emanuelturtula/DCE-GRUPO10/README.md

# DCE-GRUPO10

## Tareas pendientes 

* Eficiencia

* Distorsión
