emanuelturtula/DCE-GRUPO10/INTRODUCCION/ETAPAS/LOGICA DE CONTROL/logica.png

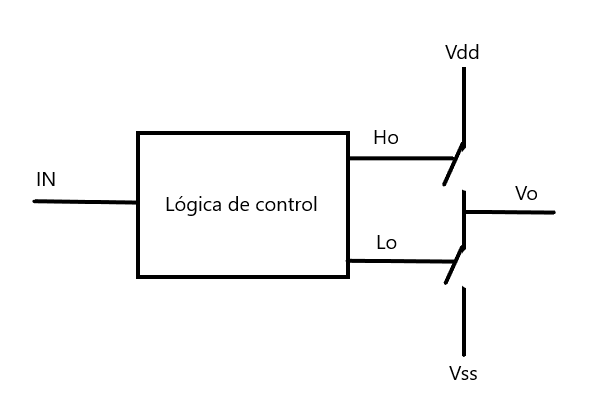
INTRODUCCION/ETAPAS/LOGICA DE CONTROL/logica.png
