emanuelturtula/DCE-GRUPO10/INTRODUCCION/ETAPAS/TRIANGULAR/generador_ideal.PNG

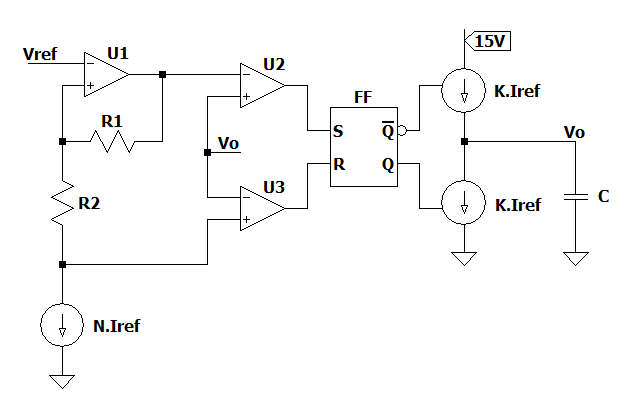
INTRODUCCION/ETAPAS/TRIANGULAR/generador_ideal.PNG
