emanuelturtula/DCE-GRUPO10/INTRODUCCION/TEORICA/diagrama.png

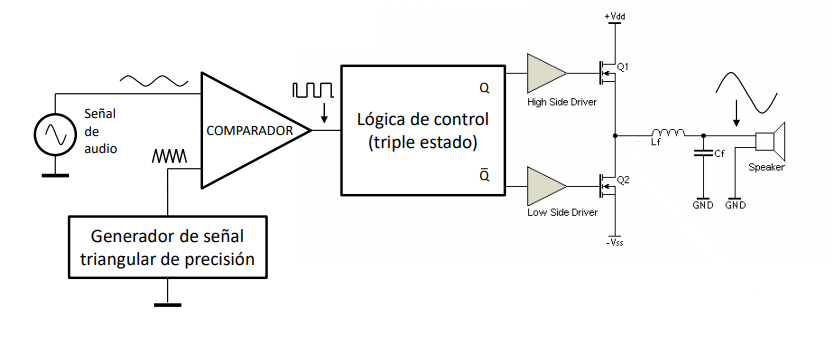
INTRODUCCION/TEORICA/diagrama.png
