emanuelturtula/DCE-GRUPO10/INTRODUCCION/TEORICA/PWM.png

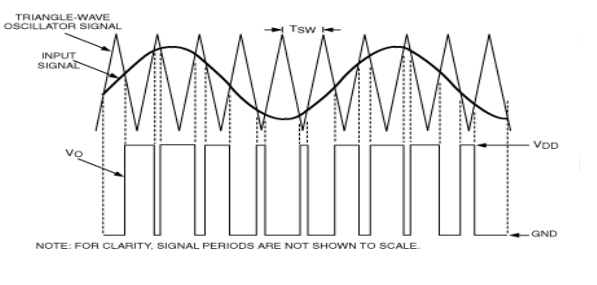
INTRODUCCION/TEORICA/PWM.png
