emanuelturtula/DCE-GRUPO10/REALIMENTADOR/PSpice/Realimentador-PSpiceFiles/SCHEMATIC1/tran/Dist_ol.png

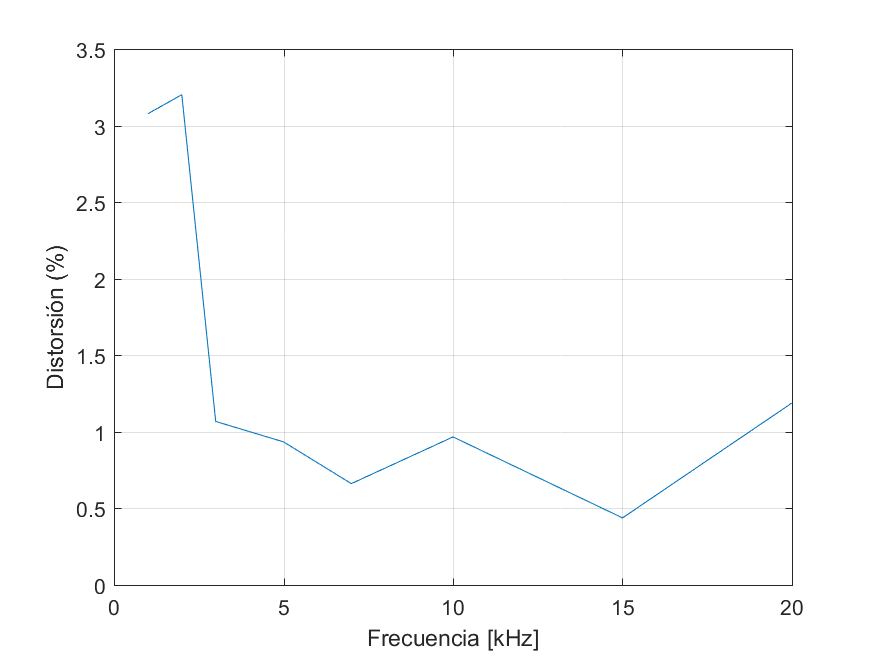
REALIMENTADOR/PSpice/Realimentador-PSpiceFiles/SCHEMATIC1/tran/Dist_ol.png
