emanuelturtula/DCE-GRUPO10/REALIMENTADOR/PSpice/Realimentador-PSpiceFiles/SCHEMATIC1/tran/Rta_cl.png

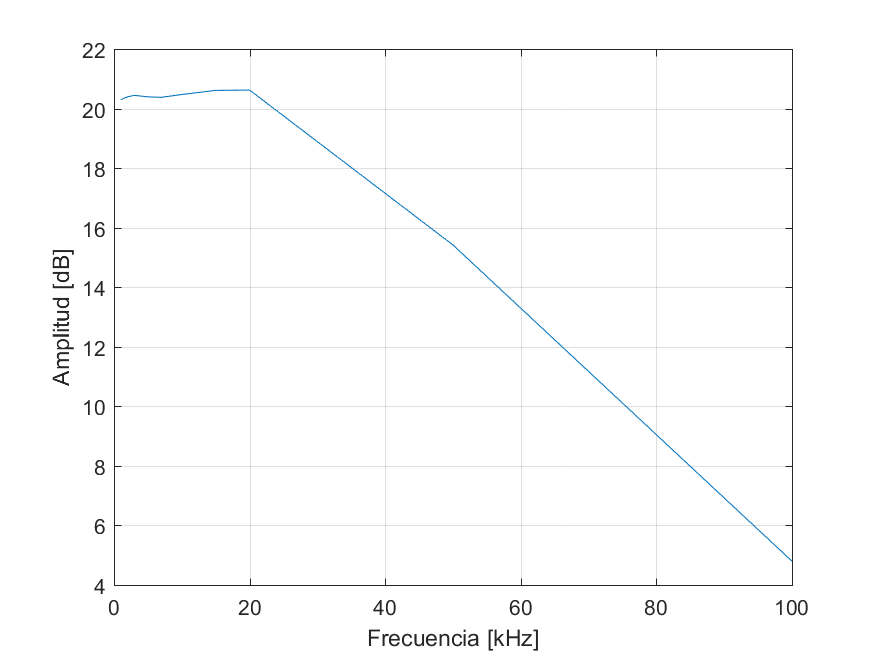
REALIMENTADOR/PSpice/Realimentador-PSpiceFiles/SCHEMATIC1/tran/Rta_cl.png
