emanuelturtula/DCE-GRUPO10/REALIMENTADOR/LTSpice/Conceptual.asc

A1: or; td=80n Vhigh=5 Vlow=0
C1: cap; {C}
C2: cap; 82p
C3: cap; 12p
Cf: cap; 330n
Lf: ind; 33µ
R1: res; 19k
R2: res; 1k
R3: res; 1k
R4: res; 1k
R5: res; 1k
R6: res; {R}
R7: res; {R}
R8: res; 10k
R9: res; 1k
RL: res; 8
S1: sw
S2: sw
SENOIDAL: voltage; SINE(0 1.1 {freq})
TRIANGULAR: voltage; PULSE(-1.5 1.5 0 2.5u 2.5u 0 5u)
U1: xcomp_x11; LM311
U2: opamp2; AD817
U3: opamp2; AD817
V1: voltage; 5
V5: voltage; 15
V6: voltage; 15
VCC: voltage; 30
VSS: voltage; 30
Named nets: 0, VEE, VCC, 5V, Vo, -15V, 15V, Vsin, Vtriang, Vf, error, Vcc
.tran 0 {STOP} {START} uic
.include UCC20520.301
Fuentes
Bibliotecas
Salida
Filtro
.include PHB27NQ10T.lib
.include BS170.301
.include LM311.301
Directivas SPICE
Entrada
Etapa de salida
.options numdgt = 15
Doble precision
.options plotwinsize = 0
Deshabilitar la compresion
.four {freq} {Narm} -1 V(vo)
.model SW SW(Ron=.01 Roff=10Meg Vt=1)
.include AD817.301
.param freq=20k
.param T=1/{freq}
.param Narm table(freq, 1k, 9, 10k, 6, 20k, 3)
.include TL082.301
.param R=100k
.param C=12p
.param fc=100k
.param STOP=(100u+11*{T})
.param START=(100u+{T})
