emanuelturtula/DCE-GRUPO10/REALIMENTADOR/LTSpice/Calculo.asc

B1: bv; V=20*delay(V(error), 200n)
B2: bv; V=delay(V(i), 200n)
C1: cap; {C}
C3: cap; {C}
C4: cap; 22p
C5: cap; 68p
Cf1: cap; 330n
Cf2: cap; 330n
Lf1: ind; 33µ
Lf2: ind; 33µ
R1: res; 1k
R3: res; 1k
R5: res; 8
R6: res; 19k
R7: res; 1k
R8: res; {R}
R9: res; {R}
R10: res; 9k
R11: res; 1k
R12: res; 19k
R13: res; 1k
R14: res; 8
U1: opamp2; AD817
U2: opamp2; AD817
V1: voltage; 5
V2: voltage; 5
V3: voltage; ""; AC 1
V4: voltage; ""; AC 1
V5: voltage; ""; AC 1
V6: voltage; ""; AC 1
V8: voltage; 15
V9: voltage; 15
V10: voltage; 30
V11: voltage; 30
Named nets: 0, -5V, 5V, 15V, -15V, vo, VEE, VCC, Vs, Vf, LC, COMP, f, i, error
.ac dec 10000 0.1 10Meg
.include AD817.301
.include LM311.301
.options plotwinsize = 0
.options numdgt = 15
.model SW SW(Ron=.01 Roff=10Meg Vt=1)
.include TL082.301
.param R=8.2k
.param C=220p
