emanuelturtula/DCE-GRUPO10/REALIMENTADOR/LTSpice/LazoAbierto-vs-LazoCerrado.asc

B1: bv; V=V(comp)*20
B2: bv; V=V(in)*20
C1: cap; 82p
C3: cap; 100p
Cf1: cap; 330n
Cf2: cap; 330n
Lf1: ind; 33µ
Lf2: ind; 33µ
R1: res; 100
R2: res; {R}
R3: res; {R}
R4: res; 100
R5: res; 8
R6: res; 19k
R7: res; 1k
R8: res; 8
R10: res; 10k
R11: res; 1k
U1: opamp2; AD817
V1: voltage; 15
V2: voltage; 15
V3: voltage; ""; AC 1
V6: voltage; ""; AC 1
Named nets: 0, -15V, 15V, error, F, comp, in, ol, cl
.ac dec 10000 0.1 100Meg
.include AD817.301
.param R=470k
