emanuelturtula/DCE-GRUPO10/DISTORSION/OTRAS/LAZO CERRADO/Dist_10k_cl.asc

A1: or; Vhigh=5  td=11n
A2: or; Vhigh=5  td=11n
B1: bv; V(if( V(error) > V(Vtriang), 5, 0))
BC1: npn
C1: cap; 1.8n
C2: cap; 1µ; IC=-7.5
C4: cap; 82p
C12: cap; 100p
Cf: cap; 330n
Lf: ind; 33µ
M3: nmos; BS170
M4: nmos; BS170
Q1: npn; BC847C
Q2: npn; BC847C
Q3: npn; BC847C
Q4: npn; BC847C
Q5: npn; BC847C
Q6: npn; BC847C
Q7: npn; BC847C
Q8: pnp; BC857C
Q9: pnp; BC857C
Q10: pnp; BC857C
Q11: pnp; BC857C
Q12: pnp; BC857C
R1: res; 560
R2: res; 560
R3: res; 1Meg
R4: res; 1Meg
R5: res; 12k
R6: res; 100
R7: res; 100
R8: res; 1k
R9: res; 1k
R10: res; 3.3k
R11: res; 100
R12: res; 100
R13: res; 100
R14: res; 100
R15: res; 1.8k
R17: res; 18k
R18: res; 1k
R19: res; 100
R20: res; 100
R21: res; {R}
R22: res; {R}
R23: res; 1k
R24: res; 10k
R26: res; 1k
RL: res; 8
S1: sw
S2: sw
SENOIDAL: voltage; SINE(0 {vin} {freq})
U1: xcomp_x11; LM311
U2: xcomp_x11; LM311
U3: opamp2; TL082
U5: opamp2; TL082
U8: opamp2; AD817
V1: voltage; 5
V2: voltage; 5
V5: voltage; 15
V6: voltage; 15
VCC: voltage; 30
VSS: voltage; 30
Named nets: 0, VCC, VEE, 5V, -5V, Vo, -15V, 15V, Vcap, Charge, Discharge, Vsin, Vtriang, error
.include UCC20520.301
Fuentes
Bibliotecas
Salida
Filtro
.include PHB27NQ10T.lib
.include BS170.301
.include LM311.301
Directivas SPICE
Generador de onda triangular
Entrada
Etapa de salida
.options numdgt = 15
Doble precision
.options plotwinsize = 0
Deshabilitar la compresion
.param freq=10k
.param time=10/{freq}+200u
.param R=470k
.tran 0 {time} 200u uic
.four {freq} {Narm} -1 V(vo)
.include AD817.301
.include TL082.301
.param Narm table(freq, 1k, 9, 10k, 6, 20k, 3)
Numero de armonicos segun frecuencia
Tiempo de simulacion para 10 períodos
NO TOCAR ESTAS DIRECTIVAS
Resistencias del amplificador de error. La ganancia es R/100
Frecuencia de entrada
.param vin=1.1
Tension de entrada pico a pico
.model SW SW(Ron=.01 Roff=10Meg Vt=1)
