emanuelturtula/DCE-GRUPO10/DISTORSION/INTERMODULACION/Intermod_1W&30W.asc

C3: cap; 2.2n
C4: cap; 33p
C5: cap; 1µ
C6: cap; 10µ
C7: cap; 10µ
C8: cap; 220n
C9: cap; 100n
C10: cap; 1n
C11: cap; 1n
C-BOOT: cap; 1µ
Cf: cap; 300n
D3: diode; MURS120
D4: diode; MURS320
D5: diode; MURS320
Lf: ind; 33µ
M1: nmos; PHB27NQ10T
M2: nmos; PHB27NQ10T
R16: res; 1k
R25: res; 2.2k
R26: res; 51
R27: res; 1.2
R28: res; 3.3
R29: res; 1.2
R30: res; 3.3
R-BOOT: res; 10
RL: res; 8
SENOIDAL_5kHZ: voltage; SINE(0 {vin}/4 5k)
SENOIDAL_100HZ: voltage; SINE(0 {vin} 100)
U4: UCC20520
U6: xcomp_x11; LM311
V1: voltage; 5
V2: voltage; 5
V3: voltage; 12
V4: voltage; PULSE(-1.5 1.5 0 2.5u 2.5u 0 5u)
V5: voltage; 15
V6: voltage; 15
VCC: voltage; 30
VSS: voltage; 30
Named nets: 0, VEE, VCC, 5V, -5V, HO, LO, Vo, DT, PWM-In, -15V, 15V, Vsin, Vtriang
.tran 0 11m 1m uic
.include UCC20520.301
Fuentes
Bibliotecas
Salida
Dead-Time
Generador PWM
Tantalio > 1u, 50V
Hoja de datos, página 28
C-BOOT > (Qg + Ivdd/fsw)/0.5
Bootstrap
1u, 50V
Lo mas cerca posible de Vdd, Vss
C-AC para reducir impedancia en AC
Hoja de datos, página 28
Cvdd tambien entrega corriente a VDDA a traves de D1
C-VDDB: 50V, 10u MLCC
C-VDDB2: 50V, 220n MLCC
C-LONG: 50V, 10u Electrolitico o Tantalio. 
Solo es necesario si las fuentes estan lejos de VDDB
Filtro para ruido de PCB
Hoja de datos, página 29
Hoja de datos, página 24
Filtro
.include PHB27NQ10T.lib
.include BS170.301
.include LM311.301
.include TL082.301
Directivas SPICE
Entrada
Etapa de salida
.step param vin list 0.2 1.1
