emanuelturtula/DCE-GRUPO10/DISTORSION/OTRAS/LAZO CERRADO/Dist_20k_cl.asc

C1: cap; {C}
C2: cap; {C}
C3: cap; 1µ
C5: cap; 10µ
C6: cap; 2.2n
C7: cap; 33p
C8: cap; 1µ
C9: cap; 100n
C10: cap; 220n
C11: cap; 10µ
C13: cap; 1n
C14: cap; 1n
Cf1: cap; 300n
D1: diode; MURS120
D2: diode; MURS320
D3: diode; MURS320
Lf1: ind; 33µ
M1: nmos; PHB27NQ10T
M2: nmos; PHB27NQ10T
R16: res; 10
R17: res; 18k
R18: res; 1k
R19: res; 1k
R20: res; 1k
R21: res; {R}
R22: res; {R}
R23: res; 1k
R25: res; 2.2k
R27: res; 51
R28: res; 3.3
R29: res; 3.3
R30: res; 1.2
R31: res; 1.2
R32: res; 1k
RL: res; 8
SENOIDAL: voltage; SINE(0 {vin} {freq})
U4: UCC20520
U6: xcomp_x11; LM311
U7: opamp2; AD817
U8: opamp2; AD817
V1: voltage; 5
V2: voltage; 5
V3: voltage; 12
V4: voltage; PULSE(-1.5 1.5 0 2.5u 2.5u 0 5u)
V5: voltage; 15
V6: voltage; 15
VCC: voltage; 30
VSS: voltage; 30
Named nets: 0, VCC, VEE, 5V, -5V, Vo, -15V, 15V, Vsin, error, HO, LO, DT, PWM-In, Vtriang
.include UCC20520.301
Fuentes
Bibliotecas
Salida
.include PHB27NQ10T.lib
.include BS170.301
.include LM311.301
Directivas SPICE
Entrada
Etapa de salida
.options numdgt = 15
Doble precision
.options plotwinsize = 0
Deshabilitar la compresion
.param freq=20k
.param time=500u+10/{freq}
.tran 0 {time} 500u uic
.four {freq} {Narm} -1 V(vo)
.include AD817.301
.include TL082.301
.param Narm table(freq, 1k, 9, 10k, 6, 20k, 3)
Numero de armonicos segun frecuencia
Tiempo de simulacion para 10 períodos
NO TOCAR ESTAS DIRECTIVAS
Resistencias del amplificador de error. La ganancia es R/100
Frecuencia de entrada
.param vin=1.1
Tension de entrada pico a pico
Dead-Time
Generador PWM
Tantalio > 1u, 50V
Hoja de datos, página 28
C-BOOT > (Qg + Ivdd/fsw)/0.5
Bootstrap
1u, 50V
Lo mas cerca posible de Vdd, Vss
C-AC para reducir impedancia en AC
Hoja de datos, página 28
Cvdd tambien entrega corriente a VDDA a traves de D1
C-VDDB: 50V, 10u MLCC
C-VDDB2: 50V, 220n MLCC
C-LONG: 50V, 10u Electrolitico o Tantalio. 
Solo es necesario si las fuentes estan lejos de VDDB
Filtro para ruido de PCB
Hoja de datos, página 29
Hoja de datos, página 24
Filtro
Etapa de salida
.param R=8.2k
.param C=220p
.param fc=100k
