emanuelturtula/DCE-GRUPO10/DISTORSION/INTERMODULACION/txt/PWLPlot.asc

V1: voltage; PWL file=pwl_1W.txt
Named nets: 0
.tran 500u
