emanuelturtula/DCE-GRUPO10/(list of files, drawings)

Other design files:
REALIMENTADOR/PSpice/Calculo.dsn
REALIMENTADOR/PSpice/Calculo.opj
REALIMENTADOR/PSpice/Realimentador.dsn
REALIMENTADOR/PSpice/Realimentador.opj
