emanuelturtula/DCE-GRUPO10/(commit log)

2019-09-18 Initial commit - Added Generador de onda triangular v1
2019-09-19 Agregué archivo de multisim
    [GeneradorTriangular.ms14]
2019-09-19 LM119 andando en multisim
    [GeneradorTriangular.ms14]
2019-09-21 Agregue el modelo del LM311 para LTSpice. Falta el esquematico
2019-09-21 Agregue el archivo de multisim de ayer
    [GeneradorTriangular.ms14]
2019-10-01 Agrego mediciones
    [GeneradorTriangular.ms14]
2019-10-01 Agrego archivos de mediciones
    [FFT.CSV, IO.CSV, IO2.CSV, RISE.CSV, VO.CSV]
2019-10-01 Arregle la branch
2019-10-01 Agregue simulaciones y esquematico
    [GeneradorTriangular.ms14, Sim.csv]
2019-10-04 Agregue archivos de salida de simulacion. Corregi .csv de simulacion. Agregue archivos de matlab para leer .csv
    [Sim.csv]
2019-12-24 Borre los contenidos de la master para empezar de nuevo
    [FFT.CSV, GeneradorTriangular.ms14, IO.CSV, IO2.CSV, RISE.CSV, Sim.csv, VO.CSV]
2020-03-11 Agrego archivo de calculo realimentador
2020-03-13 Agrego archivos de compensador
2020-03-18 Cambios de anoche
2020-03-19 Detectado el problema en el realimentador
2020-04-03 Version de PSpice andando
    [LIBRARY1.OLB, Realimentador.dsn, Realimentador.opj]
2020-04-04 Agregado nuevos archivos de PSpice
    [LIBRARY1.OLB, Realimentador.dsn, Realimentador.opj]
2020-04-04 Ultimos cambios
    [Calculo.dsn, Calculo.opj, Realimentador.dsn, Realimentador.opj]
2020-04-05 Realimentador andando
    [Calculo.dsn, Calculo.opj, Realimentador.dsn, Realimentador.opj]
2020-04-07 Ultima version de realimentador andando con buena distorsion
    [20k_ol.csv, Calculo.dsn, Calculo.opj, Realimentador.dsn, Realimentador.opj]
2020-06-08 Simulaciones de distorsión ol y cl
    [100k_cl.csv, 100k_ol.csv, 1M_cl.csv, 20k_cl.csv, 20k_ol.csv, 50k_cl.csv, 50k_ol.csv, Realimentador.dsn]
